romnith/Force-Feedback/README.md

# Force-Feedback
McGill Capstone Design Project - Force Feedback
