romnith/Force-Feedback/Arduino/README.md

## Arduino Code

* **SerialServoNano**: Code flashed to Arduino Nano to control servo motors through serial communication

* **Servo_Test**: Simple code to test servo's angle

Servo motor used: [HS-125MG Slim Metal Gear Wing Servo](https://hitecrcd.com/products/servos/micro-and-mini-servos/analog-micro-and-mini-servos/hs-125mg/product)
