romnith/Force-Feedback/openEMSstim-master/extra/images/android-app/1.a.FindTheNameOfDevice.png

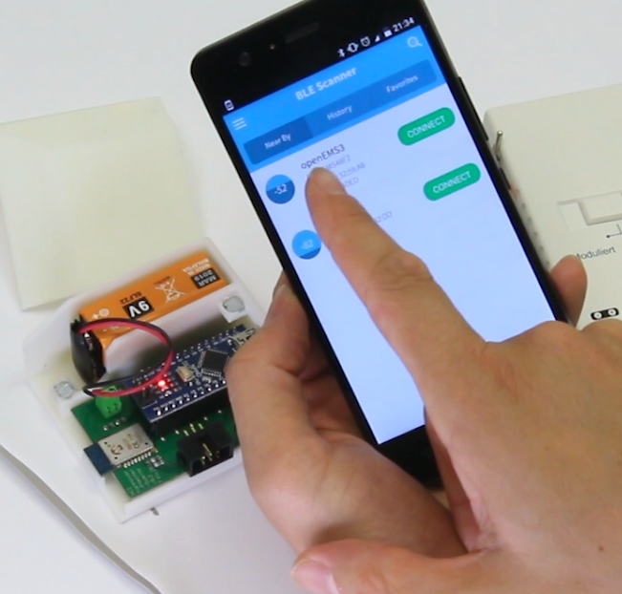
openEMSstim-master/extra/images/android-app/1.a.FindTheNameOfDevice.png
