romnith/Force-Feedback/openEMSstim-master/extra/images/android-app/1.c.BlueLEDisOn.png

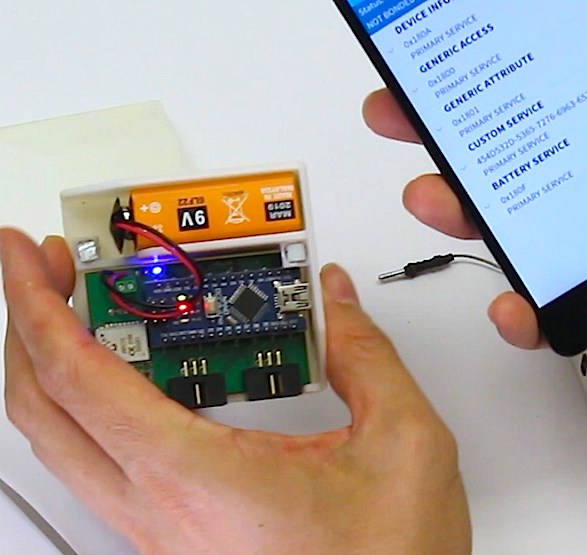
openEMSstim-master/extra/images/android-app/1.c.BlueLEDisOn.png
