romnith/Force-Feedback/openEMSstim-master/extra/images/android-app/2.CheckIfNameIsCorrectOnApp.png

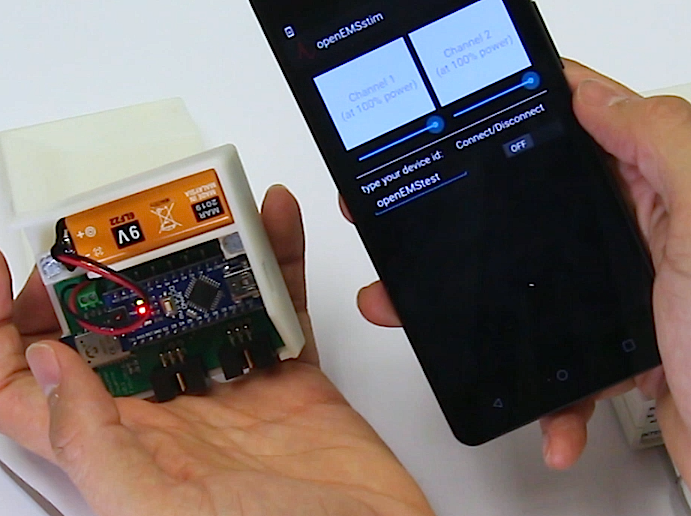
openEMSstim-master/extra/images/android-app/2.CheckIfNameIsCorrectOnApp.png
