romnith/Force-Feedback/openEMSstim-master/extra/images/android-app/2.png

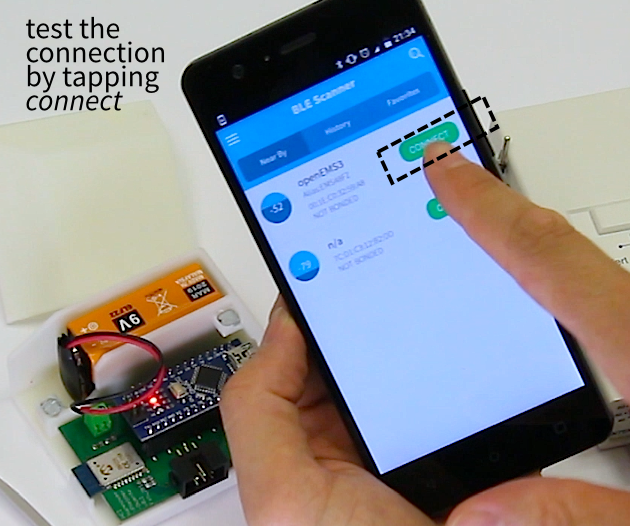
openEMSstim-master/extra/images/android-app/2.png
