romnith/Force-Feedback/openEMSstim-master/extra/images/android-app/3.ChangeTheName.png

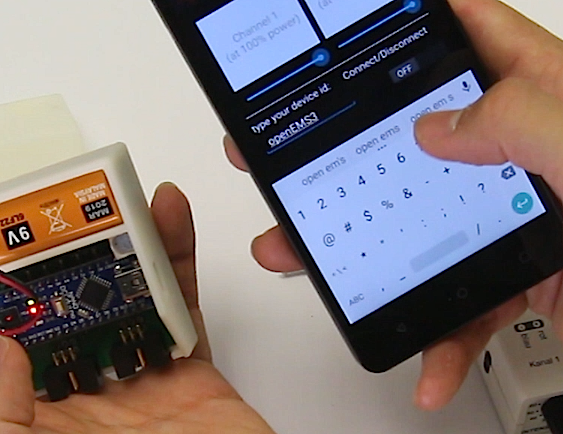
openEMSstim-master/extra/images/android-app/3.ChangeTheName.png
