romnith/Force-Feedback/openEMSstim-master/extra/images/android-app/3.png

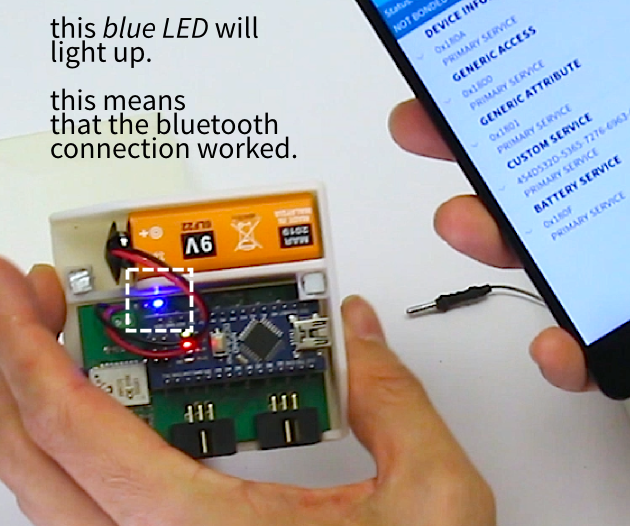
openEMSstim-master/extra/images/android-app/3.png
