romnith/Force-Feedback/openEMSstim-master/extra/images/android-app/4.Connect.png

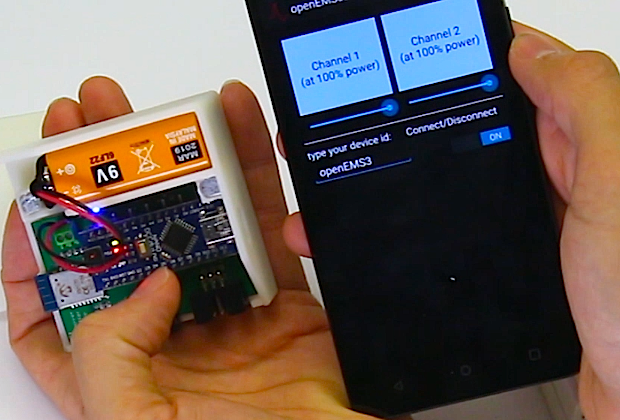
openEMSstim-master/extra/images/android-app/4.Connect.png
