romnith/Force-Feedback/openEMSstim-master/extra/images/android-app/8.SlidersIntenisty.png

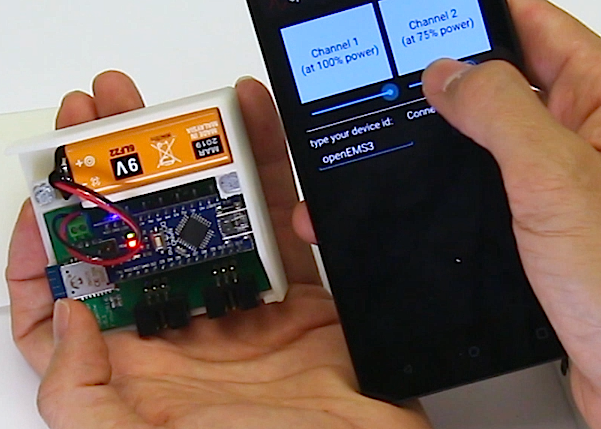
openEMSstim-master/extra/images/android-app/8.SlidersIntenisty.png
