romnith/Force-Feedback/openEMSstim-master/extra/images/cases/lasercut_casing.jpg

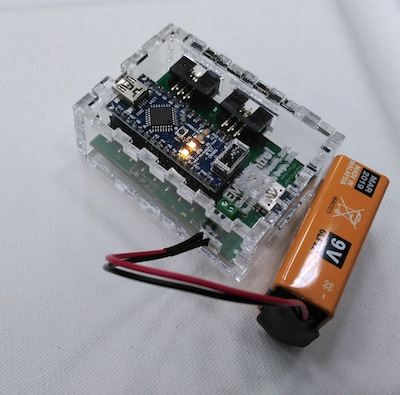
openEMSstim-master/extra/images/cases/lasercut_casing.jpg
