romnith/Force-Feedback/openEMSstim-master/extra/images/connection_diagrams/connecting_to_the_board.png

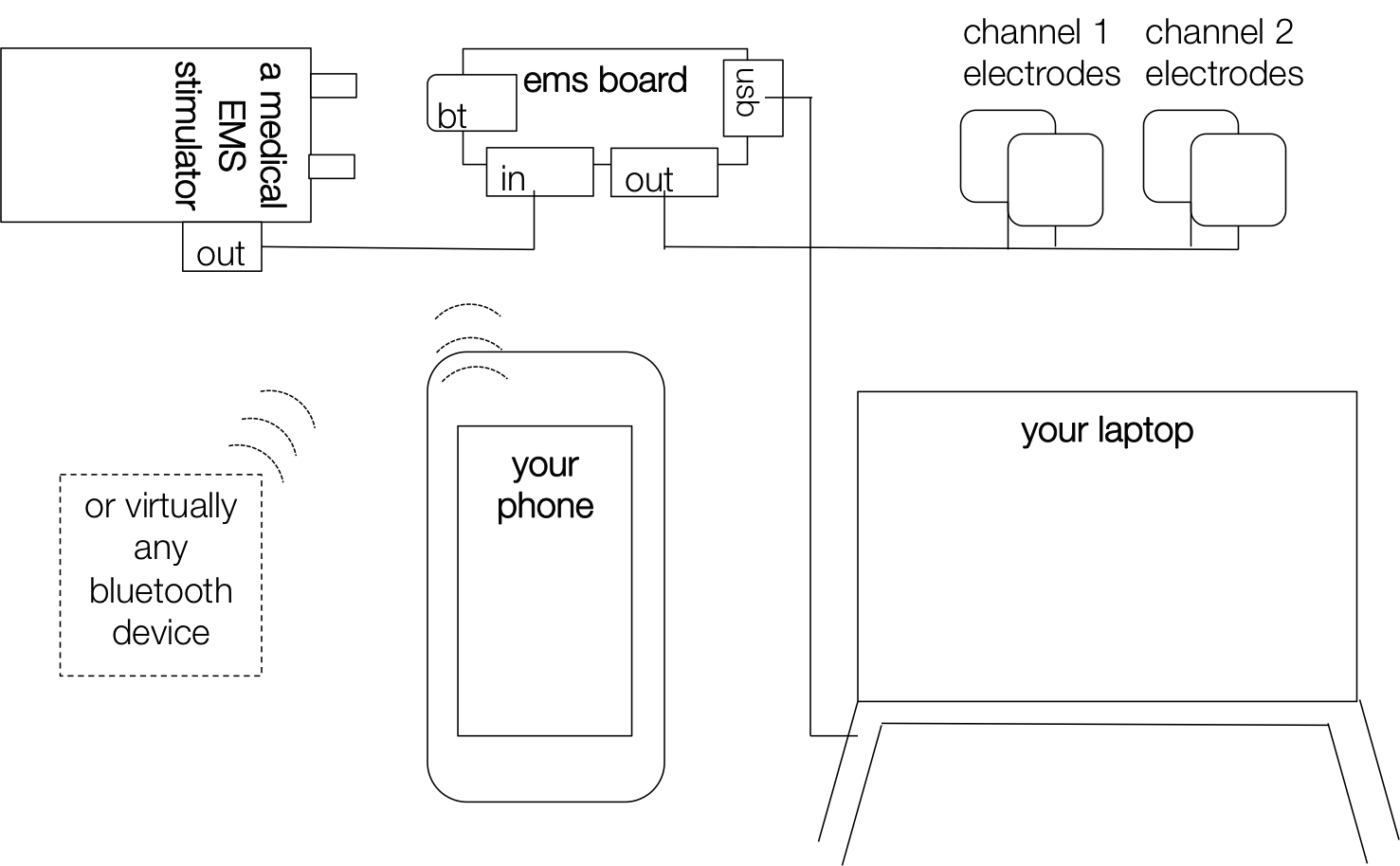
openEMSstim-master/extra/images/connection_diagrams/connecting_to_the_board.png
