romnith/Force-Feedback/openEMSstim-master/extra/images/nodejs/nodejsapp.png

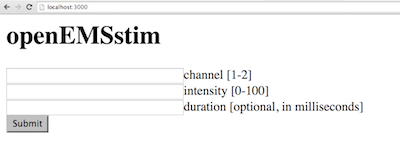
openEMSstim-master/extra/images/nodejs/nodejsapp.png
