romnith/Force-Feedback/openEMSstim-master/extra/images/powering-OFF-openEMSstim/IMG_0092.JPG

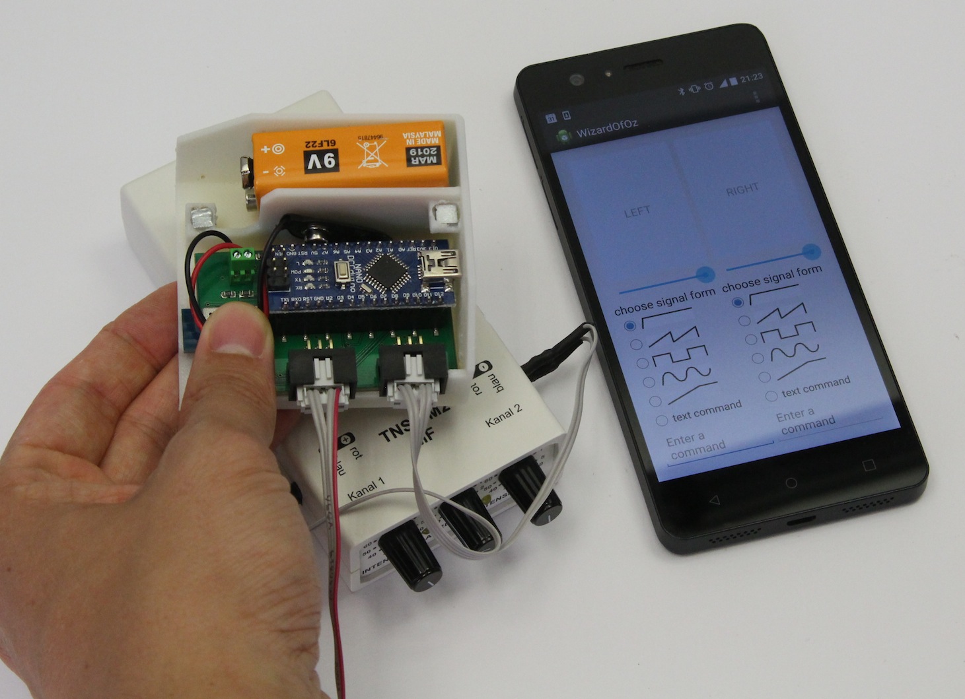
openEMSstim-master/extra/images/powering-OFF-openEMSstim/IMG_0092.JPG
