romnith/Force-Feedback/openEMSstim-master/extra/images/powering-ON-openEMSstim/2.CloseTheLid.jpeg

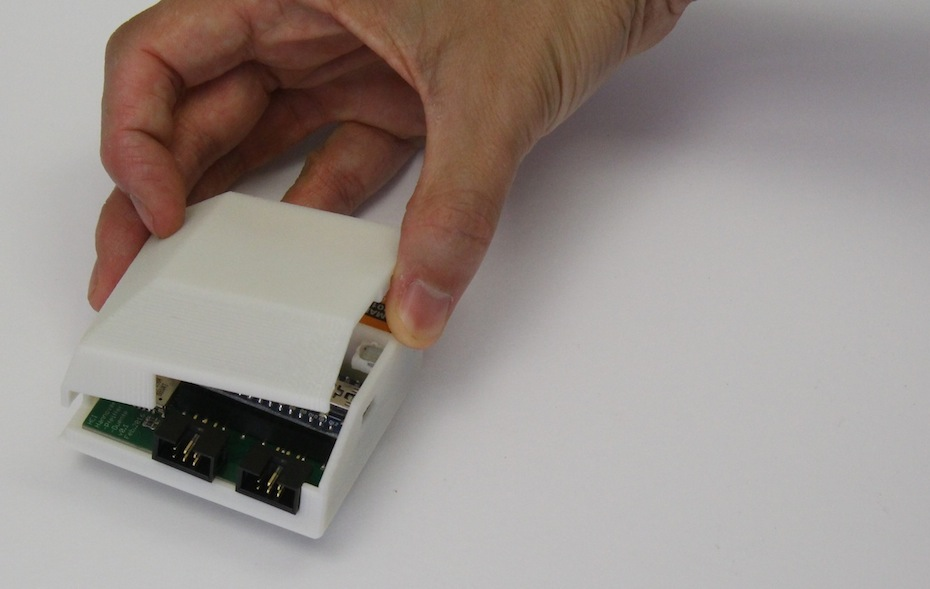
openEMSstim-master/extra/images/powering-ON-openEMSstim/2.CloseTheLid.jpeg
