romnith/Force-Feedback/openEMSstim-master/extra/images/powering-ON-openEMSstim/3.openEMSstim_lidClosed.jpeg

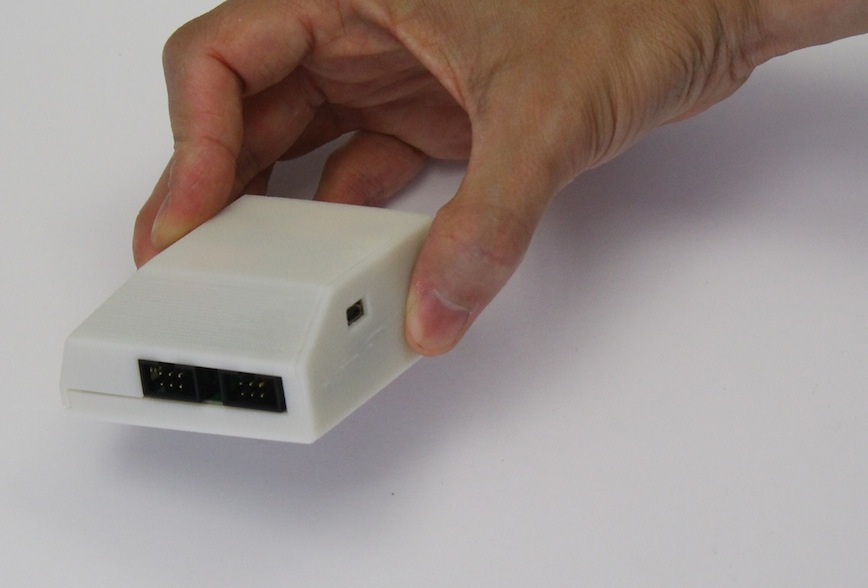
openEMSstim-master/extra/images/powering-ON-openEMSstim/3.openEMSstim_lidClosed.jpeg
