romnith/Force-Feedback/openEMSstim-master/extra/images/python-apps/ems-pong.png

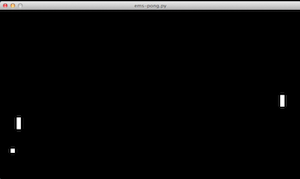
openEMSstim-master/extra/images/python-apps/ems-pong.png
