romnith/Force-Feedback/openEMSstim-master/extra/images/unity3D/1.PlayerSettings.png

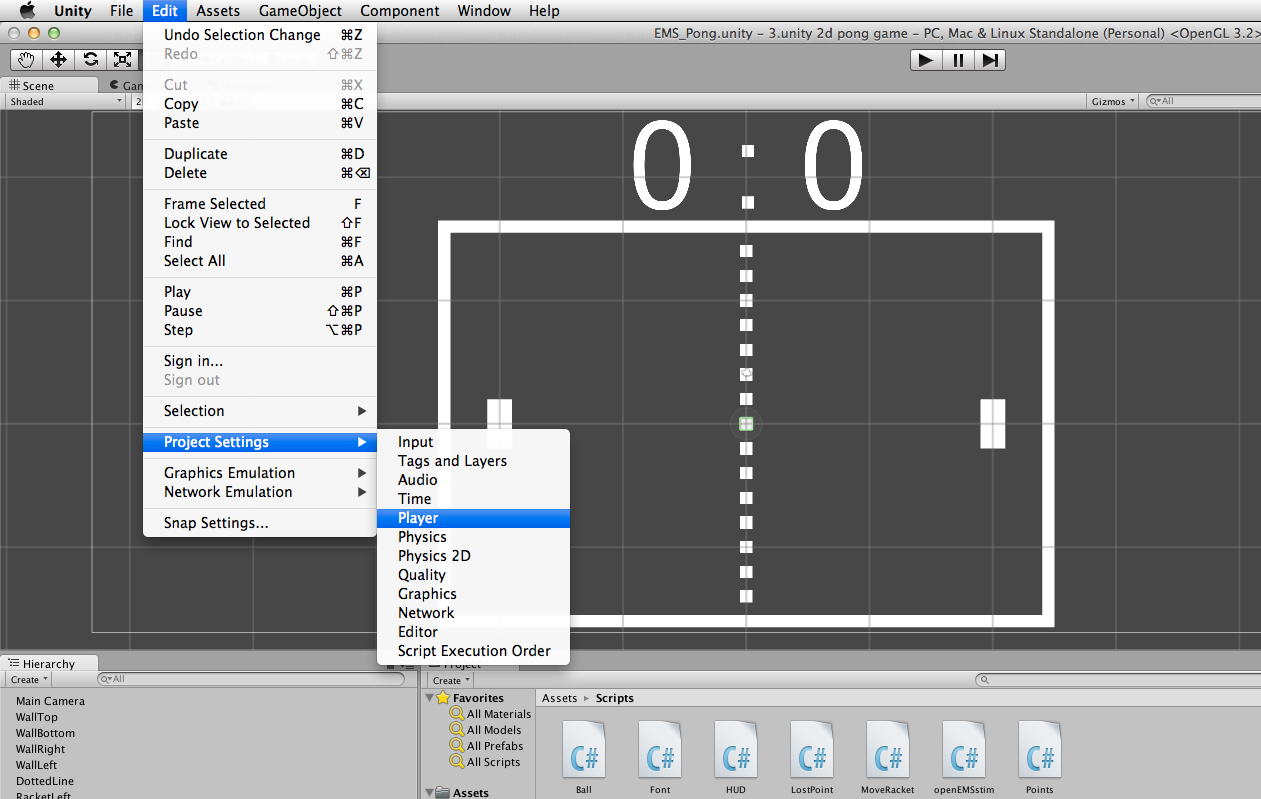
openEMSstim-master/extra/images/unity3D/1.PlayerSettings.png
