romnith/Force-Feedback/openEMSstim-master/extra/images/unity3D/2.ChangeTo.NET2.0.png

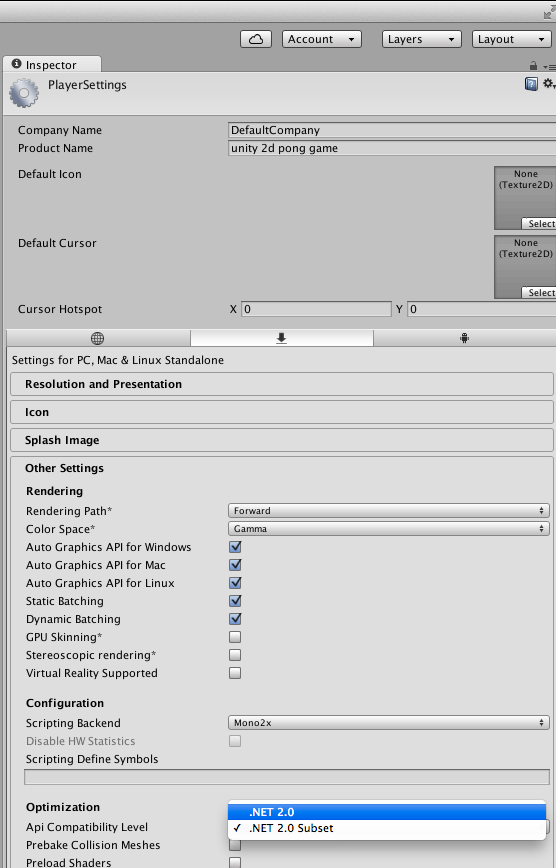
openEMSstim-master/extra/images/unity3D/2.ChangeTo.NET2.0.png
