romnith/Force-Feedback/openEMSstim-master/extra/images/unity3D/3.SelectGameObjectEMScontainer.png

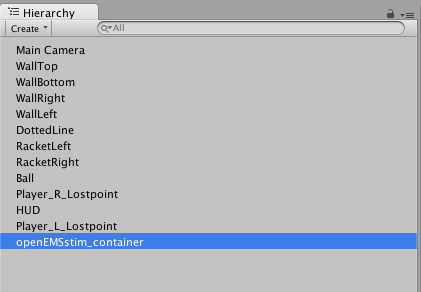
openEMSstim-master/extra/images/unity3D/3.SelectGameObjectEMScontainer.png
