romnith/Force-Feedback/openEMSstim-master/extra/images/unity3D/4.ChangeSerialPort.png

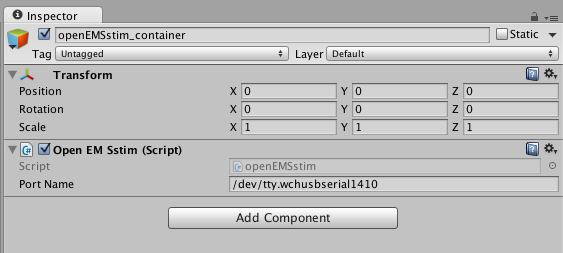
openEMSstim-master/extra/images/unity3D/4.ChangeSerialPort.png
