romnith/Force-Feedback/openEMSstim-master/extra/images/unity3D/5.ChangeCommand.png

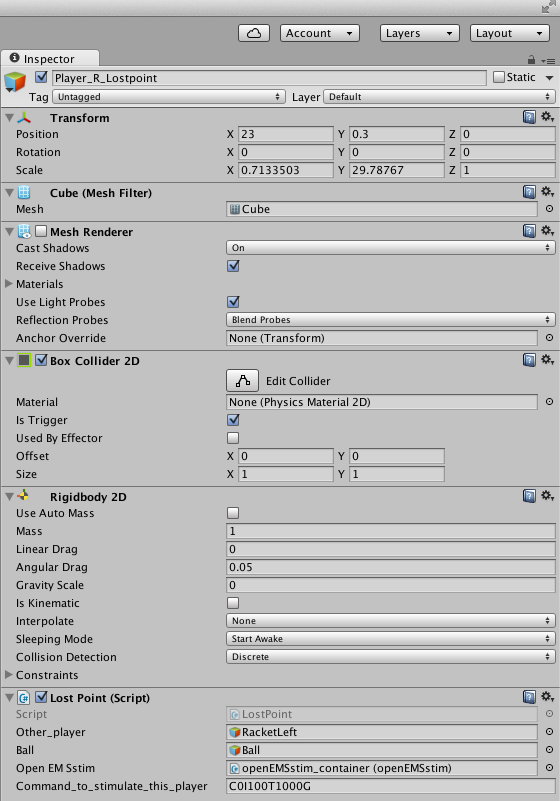
openEMSstim-master/extra/images/unity3D/5.ChangeCommand.png
