romnith/Force-Feedback/openEMSstim-master/extra/images/unity3D/EMS_Pong_Unity.png

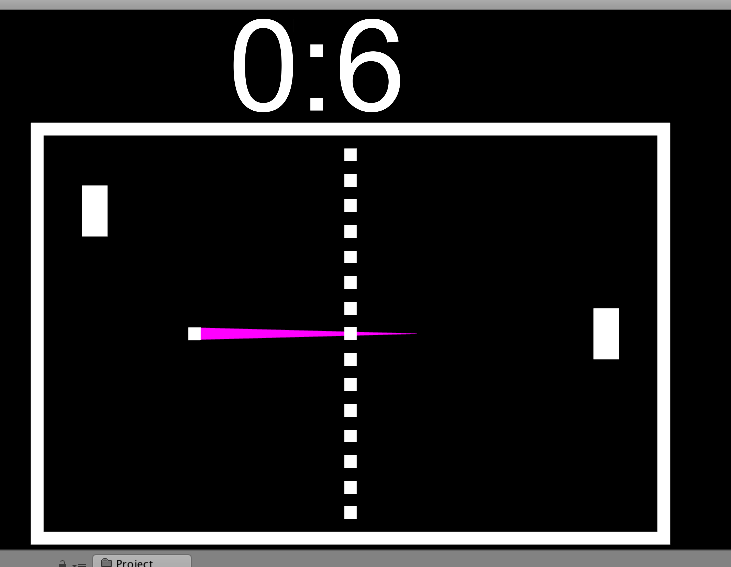
openEMSstim-master/extra/images/unity3D/EMS_Pong_Unity.png
