romnith/Force-Feedback/Unity/MotiveDirect-master/Assets/MixedRealityToolkit-Examples/Demos/StandardShader/Textures/Bricks_normal.png

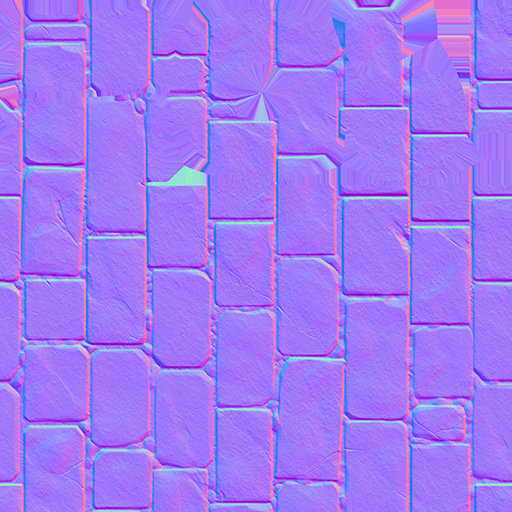
Unity/MotiveDirect-master/Assets/MixedRealityToolkit-Examples/Demos/StandardShader/Textures/Bricks_normal.png
