romnith/Force-Feedback/Unity/MotiveDirect-master/Assets/MixedRealityToolkit-Examples/Demos/StandardShader/Textures/Fabric_normal.png

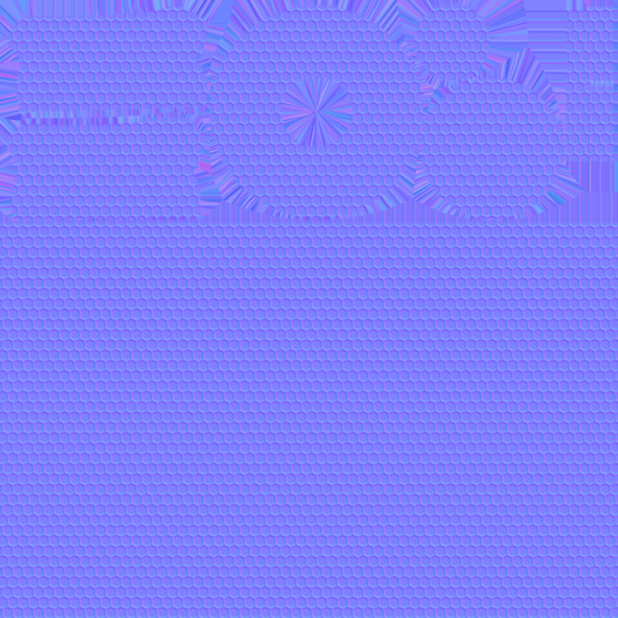
Unity/MotiveDirect-master/Assets/MixedRealityToolkit-Examples/Demos/StandardShader/Textures/Fabric_normal.png
