romnith/Force-Feedback/Unity/MotiveDirect-master/Assets/MixedRealityToolkit-Examples/Demos/StandardShader/Textures/OpaqueHoverLight_albedo.png

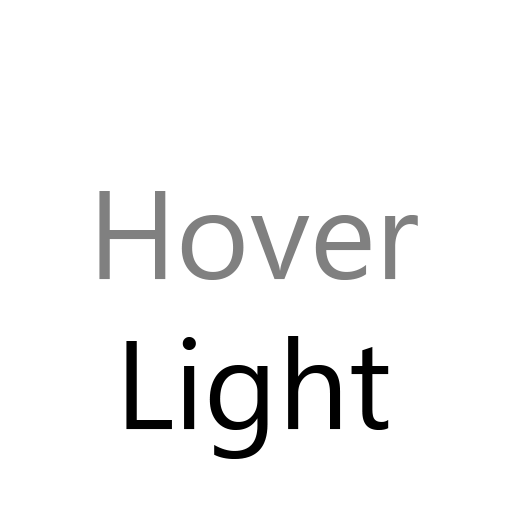
Unity/MotiveDirect-master/Assets/MixedRealityToolkit-Examples/Demos/StandardShader/Textures/OpaqueHoverLight_albedo.png
