romnith/Force-Feedback/Unity/MotiveDirect-master/Assets/MixedRealityToolkit/_Core/Resources/Textures/Generic_controller_black_scaled.png

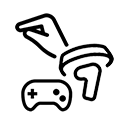
Unity/MotiveDirect-master/Assets/MixedRealityToolkit/_Core/Resources/Textures/Generic_controller_black_scaled.png
