romnith/Force-Feedback/Unity/MotiveDirect-master/Assets/MixedRealityToolkit/_Core/Resources/Textures/MotionController_left_white.png

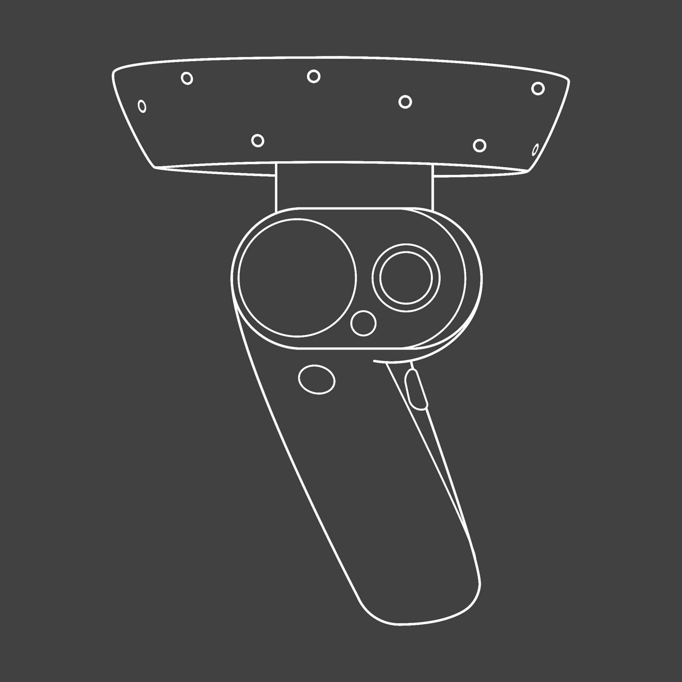
Unity/MotiveDirect-master/Assets/MixedRealityToolkit/_Core/Resources/Textures/MotionController_left_white.png
