romnith/Force-Feedback/Unity/MotiveDirect-master/Assets/Models/TableModel/_Models/Table_Textures/Table_New_Connected_Low_Metal_Normal.png

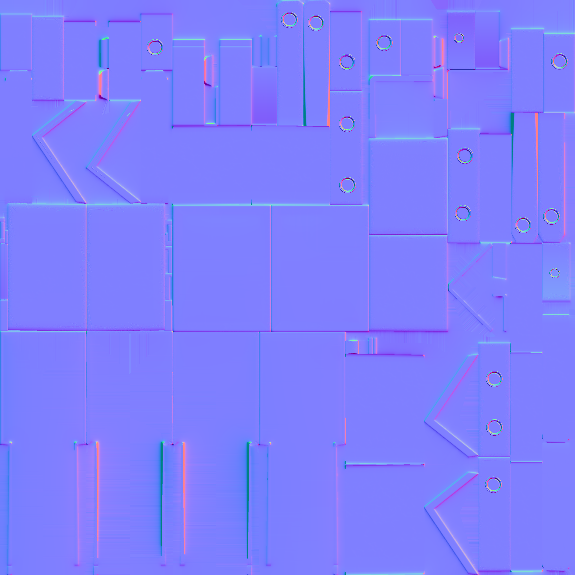
Unity/MotiveDirect-master/Assets/Models/TableModel/_Models/Table_Textures/Table_New_Connected_Low_Metal_Normal.png
