romnith/Force-Feedback/openEMSstim-master/hardware/Casings/3dPrintedCasing/bottom-part.stl

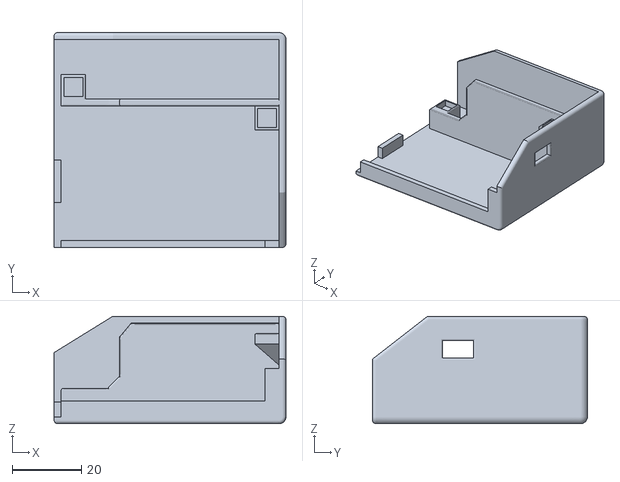
[picture p79: CAD file, 2018-11-25]
openEMSstim-master/hardware/Casings/3dPrintedCasing/bottom-part.stl
67.0 x 62.0 x 31.0
