romnith/Force-Feedback/Unity/MotiveDirect-master/Assets/Models/Bottle.obj

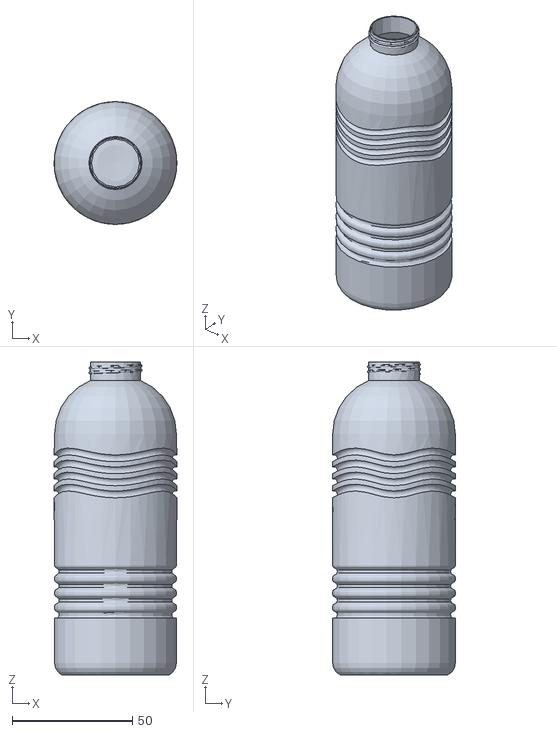
[picture p80: CAD file, 2018-10-29]
Unity/MotiveDirect-master/Assets/Models/Bottle.obj
51.0 x 51.0 x 130.0
