romnith/Force-Feedback/openEMSstim-master/hardware/Casings/3dPrintedCasing/top-part.stl

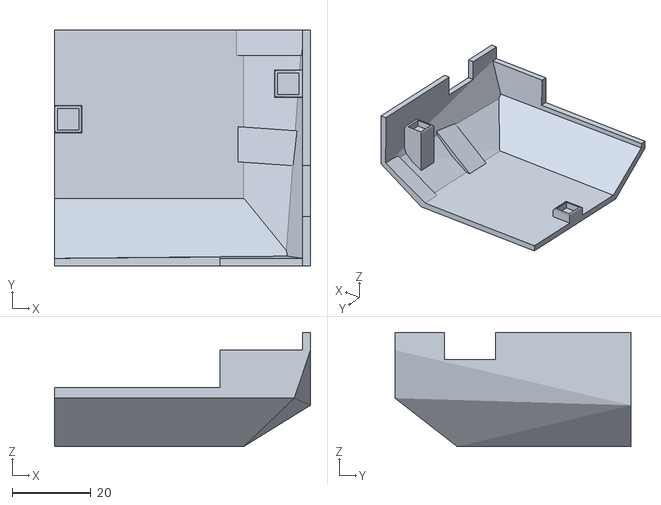
[picture p81: CAD file, 2018-11-25]
openEMSstim-master/hardware/Casings/3dPrintedCasing/top-part.stl
65.0 x 60.0 x 29.0
