romnith/Force-Feedback/openEMSstim-master/extra/images/building/Connectors.jpg

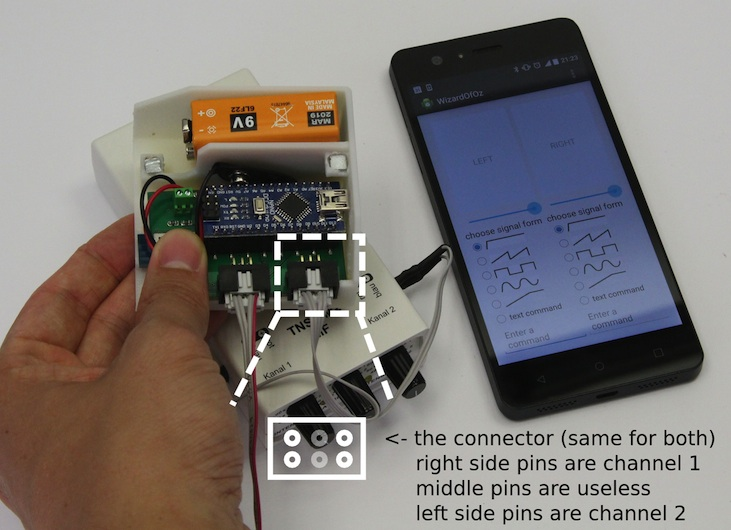
openEMSstim-master/extra/images/building/Connectors.jpg
