romnith/Force-Feedback/openEMSstim-master/extra/images/cases/3dPrintedCasing.jpg

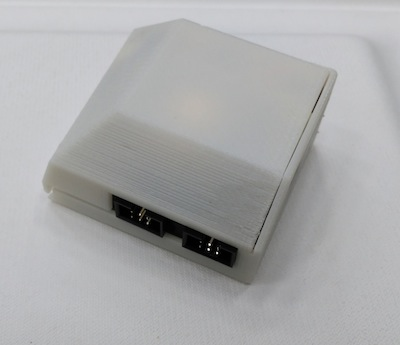
openEMSstim-master/extra/images/cases/3dPrintedCasing.jpg
