romnith/Force-Feedback/openEMSstim-master/extra/images/getting-started/2-checking-ID.jpeg

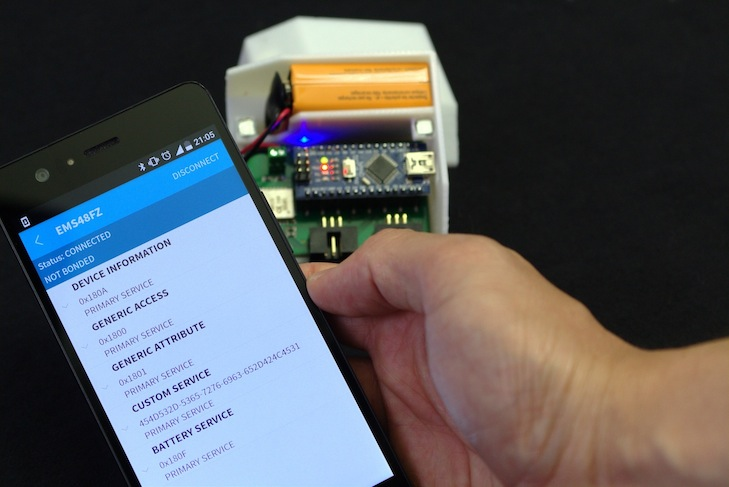
openEMSstim-master/extra/images/getting-started/2-checking-ID.jpeg
