romnith/Force-Feedback/openEMSstim-master/extra/images/getting-started/3-conecting-via-Android.jpeg

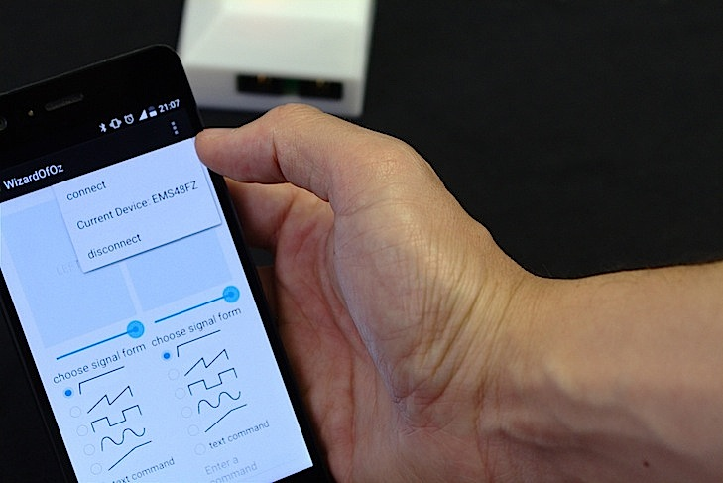
openEMSstim-master/extra/images/getting-started/3-conecting-via-Android.jpeg
