romnith/Force-Feedback/openEMSstim-master/extra/images/youtube/tutorial-EMSbasics.png

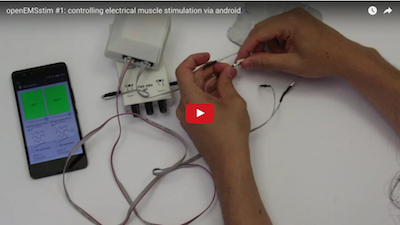
openEMSstim-master/extra/images/youtube/tutorial-EMSbasics.png
