romnith/Force-Feedback/openEMSstim-master/extra/images/android-app/1.b.TapConnectToTest.png

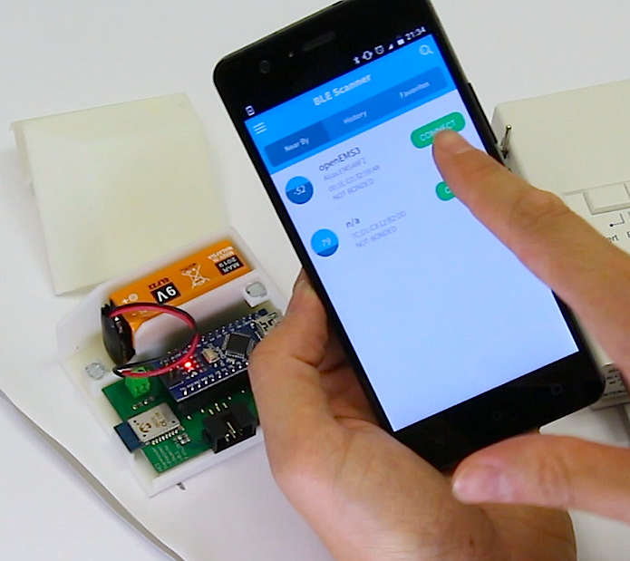
openEMSstim-master/extra/images/android-app/1.b.TapConnectToTest.png
