romnith/Force-Feedback/openEMSstim-master/extra/images/android-app/6.TestLEDsForRight.png

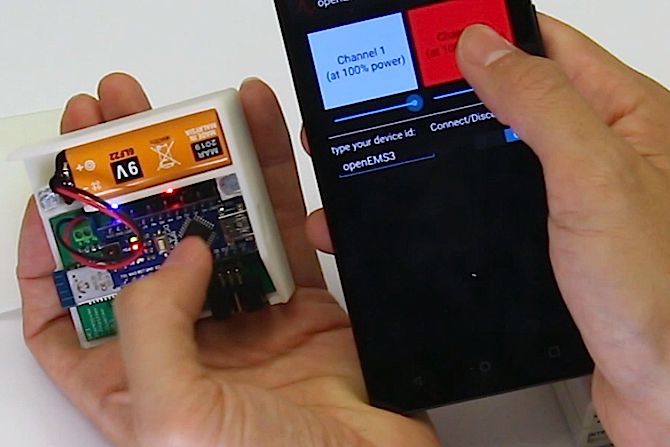
openEMSstim-master/extra/images/android-app/6.TestLEDsForRight.png
