romnith/Force-Feedback/openEMSstim-master/extra/images/android-app/7.TestLEDsForLeft.png

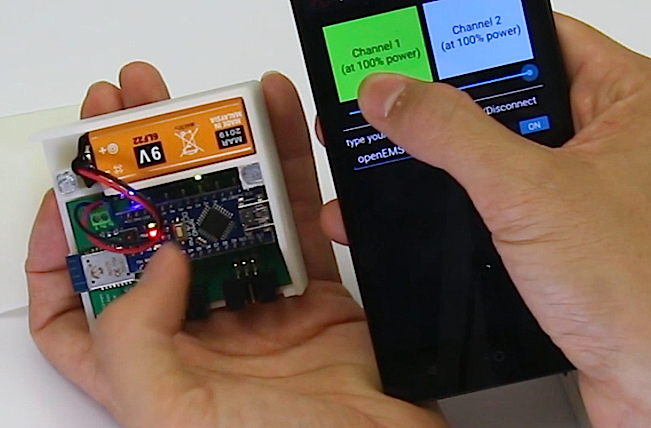
openEMSstim-master/extra/images/android-app/7.TestLEDsForLeft.png
