romnith/Force-Feedback/Unity/Force Feedback Leap Test/Assets/LeapMotion/Core/EditorResources/HandTex.png

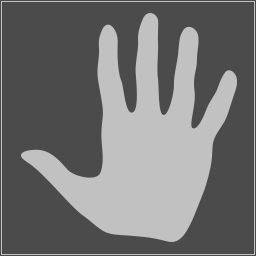
Unity/Force Feedback Leap Test/Assets/LeapMotion/Core/EditorResources/HandTex.png
