romnith/Force-Feedback/Unity/Force Feedback Leap Test/Assets/LeapMotion/Core/Gizmos/leap_motion.png

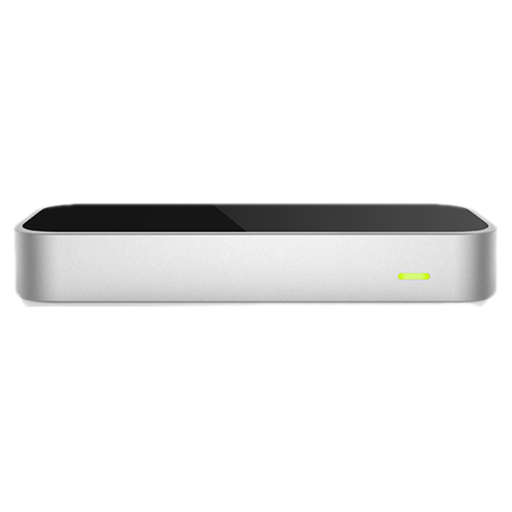
Unity/Force Feedback Leap Test/Assets/LeapMotion/Core/Gizmos/leap_motion.png
