romnith/Force-Feedback/Unity/Force Feedback Leap Test/Assets/LeapMotion/Core/Textures/LoPolyHand_Color.png

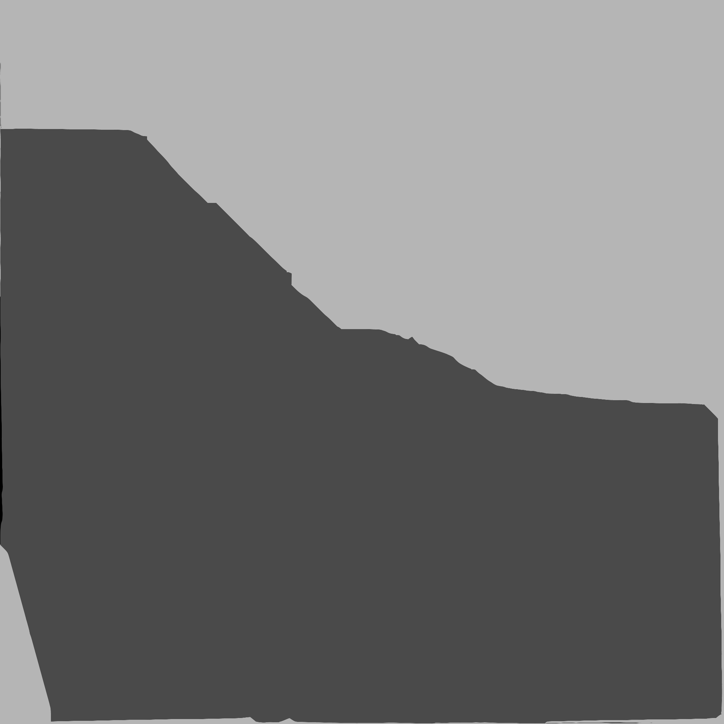
Unity/Force Feedback Leap Test/Assets/LeapMotion/Core/Textures/LoPolyHand_Color.png
