romnith/Force-Feedback/Unity/Force Feedback Leap Test/Assets/LeapMotion/Core/Textures/PluginLeapNotice.png

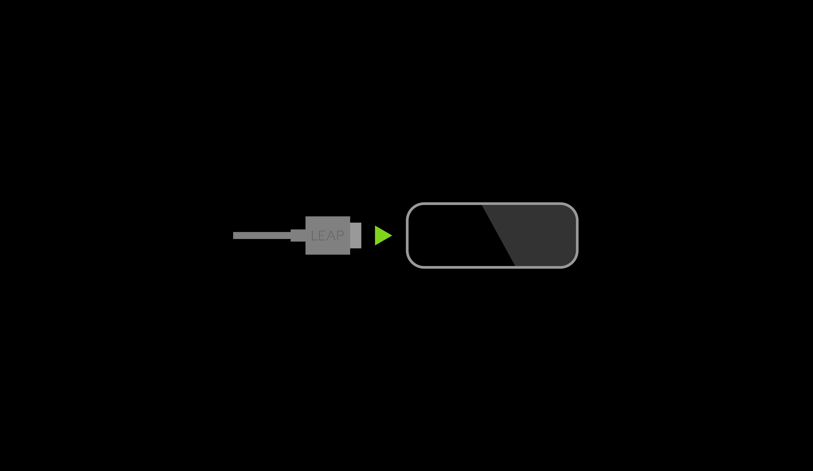
Unity/Force Feedback Leap Test/Assets/LeapMotion/Core/Textures/PluginLeapNotice.png
