romnith/Force-Feedback/Unity/Force Feedback Leap Test/Assets/LeapMotion/Core/Textures/PluginLeapNoticeLarge.png

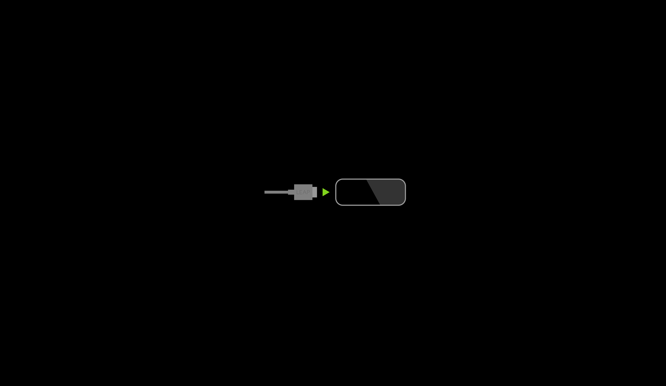
Unity/Force Feedback Leap Test/Assets/LeapMotion/Core/Textures/PluginLeapNoticeLarge.png
