romnith/Force-Feedback/openEMSstim-master/hardware/schematics/openEMSstim_03.brd

## EAGLE design openEMSstim-master/hardware/schematics/openEMSstim_03.brd (2018-11-25)

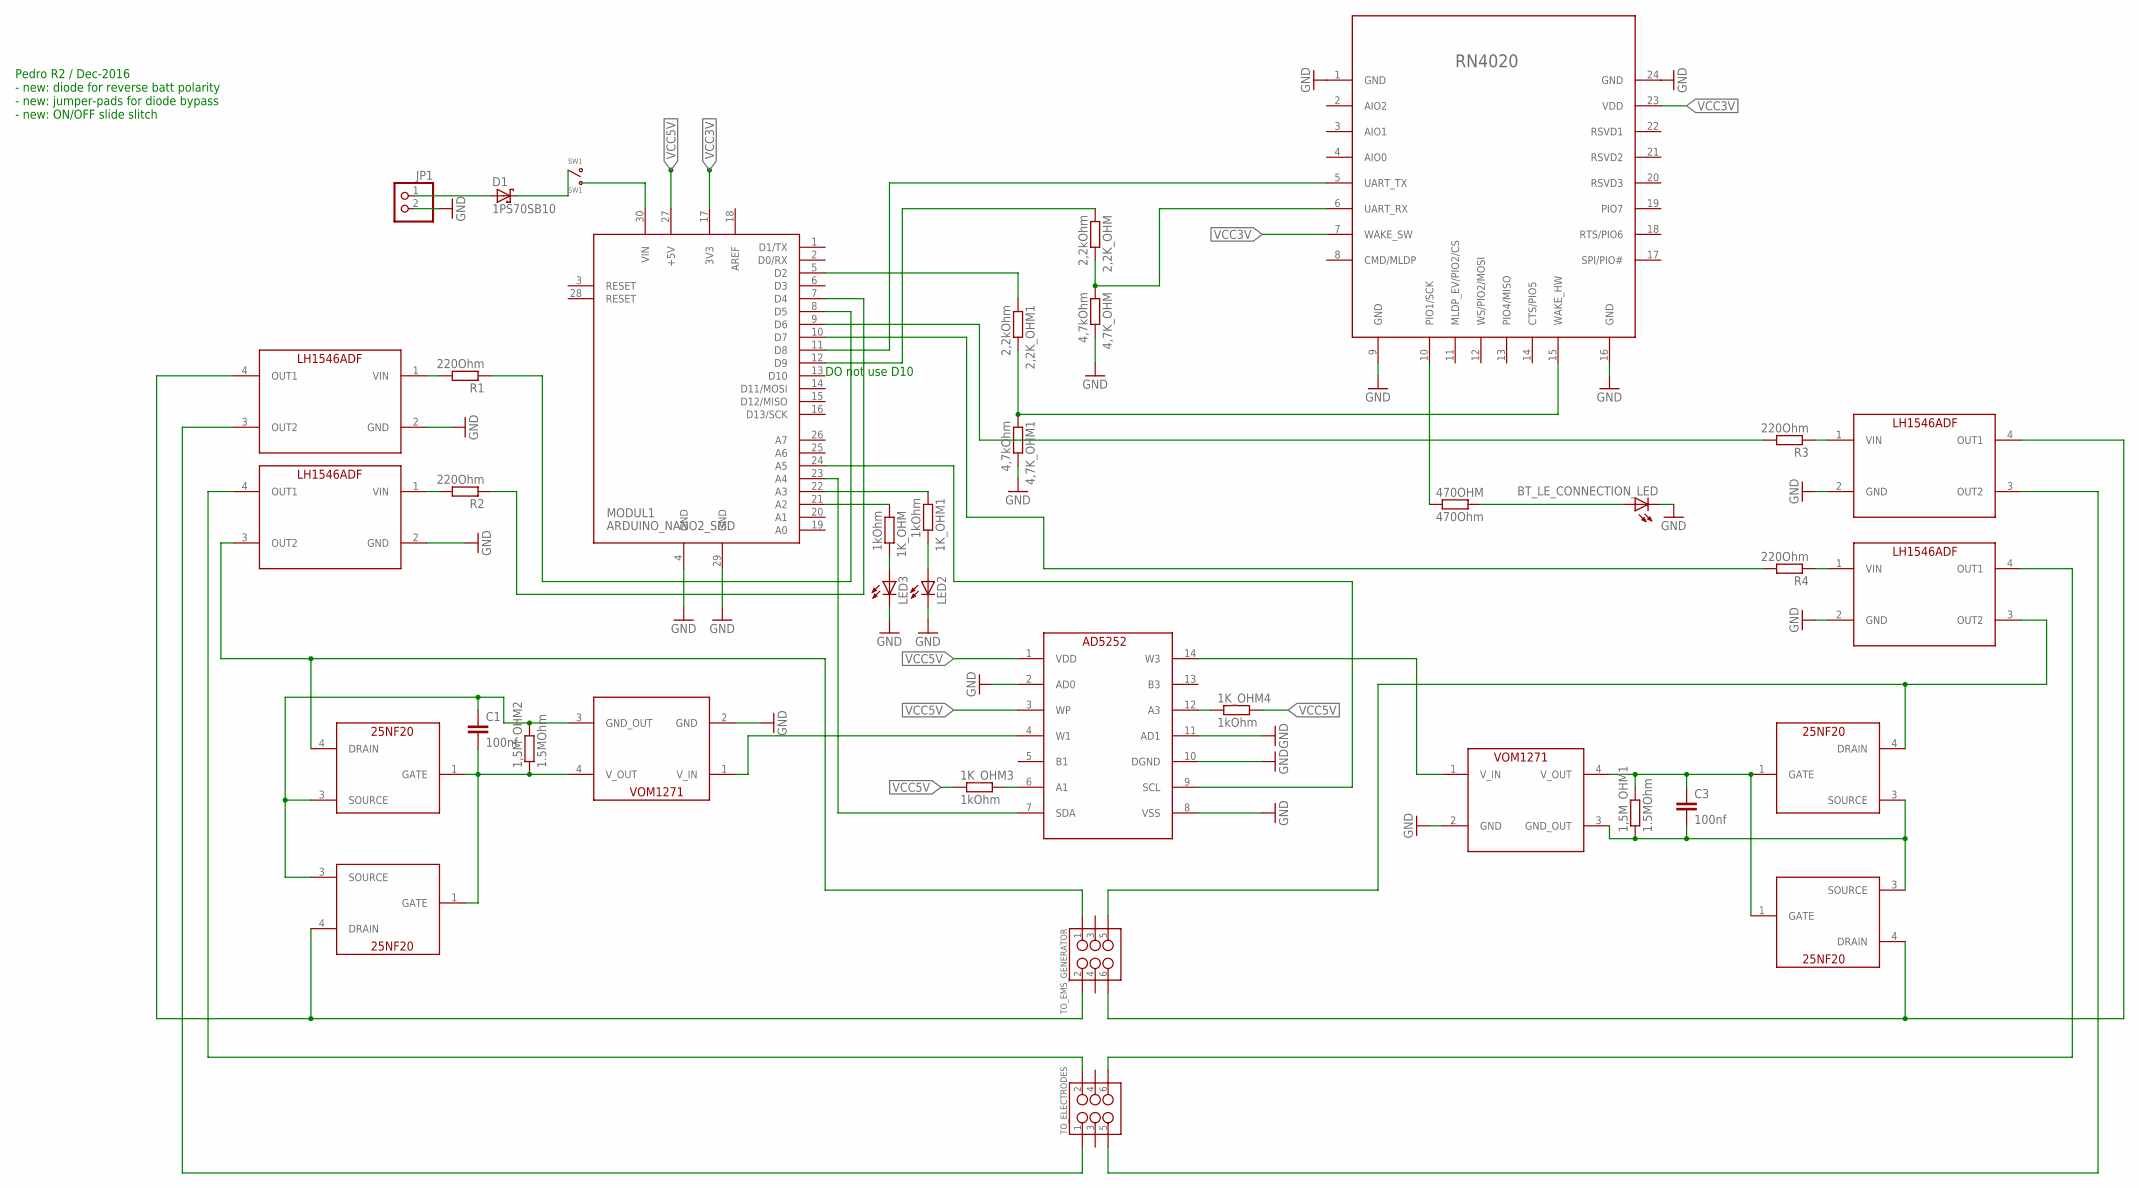
[picture p113: schematic openEMSstim_03.sch]

Parts:
1,5M_OHM1, 1,5M_OHM2: 1.5MOhm; R0805
1K_OHM, 1K_OHM1, 1K_OHM3, 1K_OHM4: 1kOhm; R0805
2,2K_OHM, 2,2K_OHM1: 2,2kOhm; R0805
4,7K_OHM, 4,7K_OHM1: 4,7kOhm; R0805
470OHM: 470Ohm; R0805
BT_LE_CONNECTION_LED: LEDCHIPLED_0603; CHIPLED_0603
C1, C3: 100nf; 0805
D1: 1PS70SB10; SOT323
JP1: PINHD-1X2; 1X02
LED2, LED3: LEDCHIPLED_0603; CHIPLED_0603
MODUL1: ARDUINO_NANO2_SMD
MOS01, MOS02, MOS03, MOS04: DEV; PACK
R1, R2, R3, R4: 220Ohm; R0805
SW1: SW1; SSSS810701
TO_ELECTRODES: M03X2; RIGHT_ANGLED_SHROUED_2X06_6PIN
TO_EMS_GENERATOR: M03X2; RIGHT_ANGLED_SHROUED_2X06_6PIN
U$5: RN4020
U$6: AD5252; TSSOP
U$9, U$10: VOM1271; SOP04
U$11, U$12, U$13, U$14: LH1546ADF; DIP04-SMD

Connections:
AREF: MODUL1.18 (AREF)
GND: 4,7K_OHM.2, 4,7K_OHM1.2, BT_LE_CONNECTION_LED.C, JP1.2, LED2.C, LED3.C, MODUL1.4 (GND), MODUL1.29 (GND), U$5.1 (GND), U$5.9 (GND), U$5.16 (GND), U$5.24 (GND), U$6.2 (AD0), U$6.8 (VSS), U$6.10 (DGND), U$6.11 (AD1), U$9.2 (GND), U$10.2 (GND), U$11.2 (GND), U$12.2 (GND), U$13.2 (GND), U$14.2 (GND)
unnamed: U$6.4 (W1), U$9.1 (V_IN)
unnamed: 1K_OHM.1, MODUL1.21 (A2)
unnamed: MODUL1.23 (A4), U$6.7 (SDA)
unnamed: TO_ELECTRODES.6, U$14.4 (OUT1)
unnamed: 2,2K_OHM.2, 4,7K_OHM.1, U$5.6 (UART_RX)
unnamed: 2,2K_OHM.1, MODUL1.12 (D9)
unnamed: TO_ELECTRODES.1, U$11.3 (OUT2)
unnamed: 1,5M_OHM2.1, C1.2, MOS01.1 (GATE), MOS02.1 (GATE), U$9.4 (V_OUT)
unnamed: MODUL1.11 (D8), U$5.5 (UART_TX)
unnamed: MODUL1.24 (A5), U$6.9 (SCL)
unnamed: MODUL1.30 (VIN), SW1.1 (B)
unnamed: R2.2, U$12.1 (VIN)
unnamed: TO_ELECTRODES.2, U$12.4 (OUT1)
unnamed: R1.2, U$11.1 (VIN)
unnamed: R3.1, U$13.1 (VIN)
unnamed: R4.1, U$14.1 (VIN)
unnamed: MODUL1.8 (D5), R1.1
unnamed: MODUL1.7 (D4), R2.1
unnamed: MODUL1.9 (D6), R3.2
unnamed: MODUL1.10 (D7), R4.2
unnamed: MOS01.4 (DRAIN), TO_EMS_GENERATOR.1, U$12.3 (OUT2)
unnamed: U$6.14 (W3), U$10.1 (V_IN)
unnamed: 1,5M_OHM1.2, C3.1, MOS03.1 (GATE), MOS04.1 (GATE), U$10.4 (V_OUT)
unnamed: 1,5M_OHM1.1, C3.2, MOS03.3 (SOURCE), MOS04.3 (SOURCE), U$10.3 (GND_OUT)
unnamed: 1K_OHM4.1, U$6.12 (A3)
unnamed: 1,5M_OHM2.2, C1.1, MOS01.3 (SOURCE), MOS02.3 (SOURCE), U$9.3 (GND_OUT)
unnamed: MOS03.4 (DRAIN), TO_EMS_GENERATOR.5, U$14.3 (OUT2)
unnamed: MOS02.4 (DRAIN), TO_EMS_GENERATOR.2, U$11.4 (OUT1)
unnamed: TO_ELECTRODES.5, U$13.3 (OUT2)
unnamed: MOS04.4 (DRAIN), TO_EMS_GENERATOR.6, U$13.4 (OUT1)
unnamed: 2,2K_OHM1.2, 4,7K_OHM1.1, U$5.15 (WAKE_HW)
unnamed: 1K_OHM3.2, U$6.6 (A1)
unnamed: 2,2K_OHM1.1, MODUL1.5 (D2)
unnamed: 470OHM.1, U$5.10 (PIO1/SCK)
unnamed: 470OHM.2, BT_LE_CONNECTION_LED.A
unnamed: 1K_OHM1.2, LED2.A
unnamed: 1K_OHM1.1, MODUL1.22 (A3)
unnamed: 1K_OHM.2, LED3.A
unnamed: D1.1 (A), JP1.1
unnamed: D1.3 (K), SW1.2 (COM)
VCC3V: MODUL1.17 (3V3), U$5.7 (WAKE_SW), U$5.23 (VDD)
VCC5V: 1K_OHM3.1, 1K_OHM4.2, MODUL1.27 (+5V), U$6.1 (VDD), U$6.3 (WP)

Notes on the sheet:
DO not use D10
Pedro R2 / Dec-2016 - new: diode for reverse batt polarity - new: jumper-pads for diode bypass - new: ON/OFF slide slitch

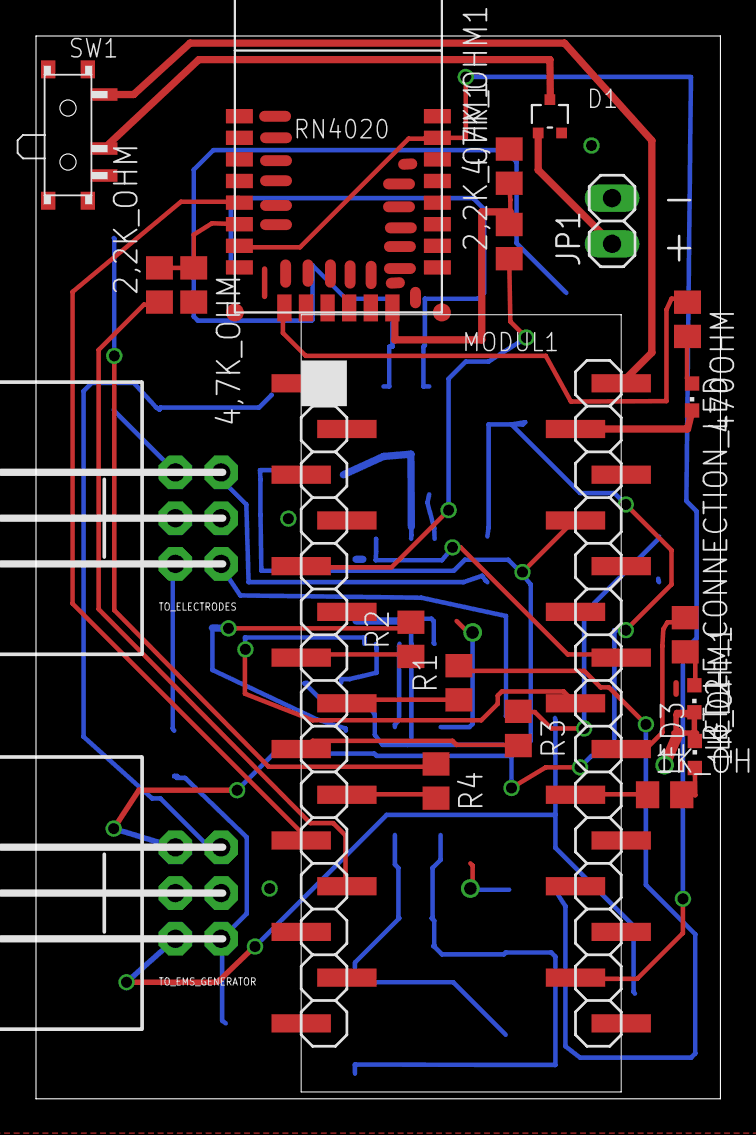
[picture p114: board openEMSstim_03.brd from above]

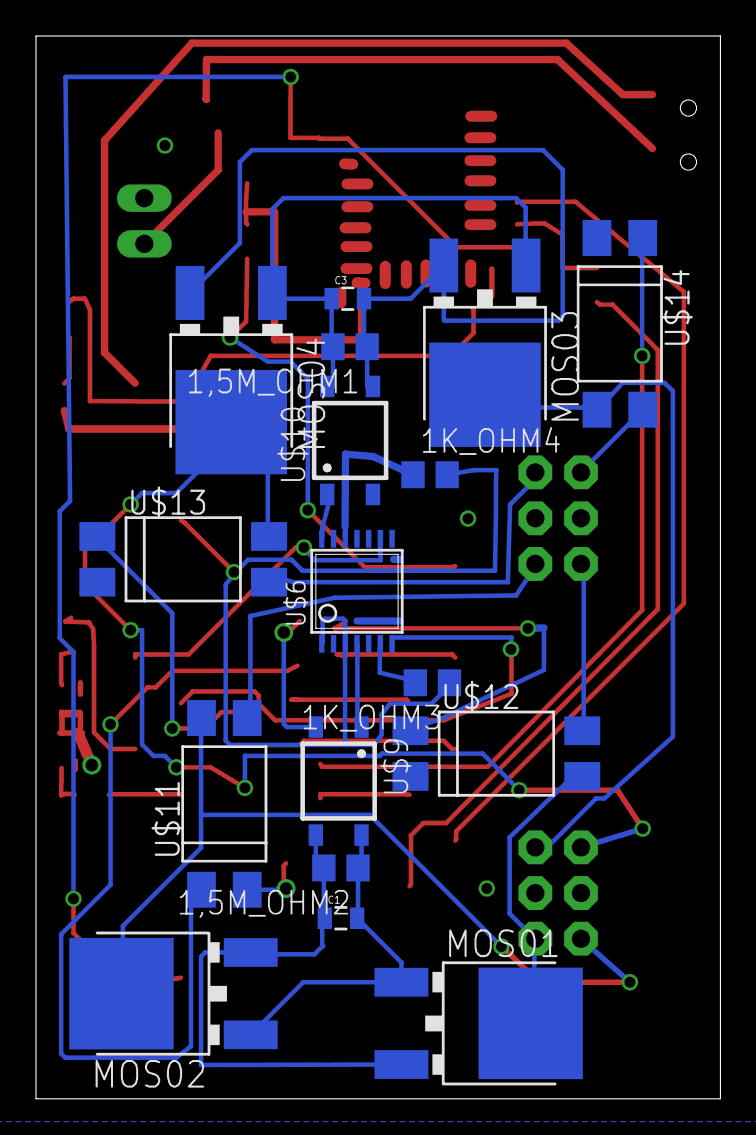
[picture p115: board openEMSstim_03.brd from below]

Board: 2 copper layers, 38.0 x 59.0 mm, 38 parts (17 on the bottom side), 43 nets.
