romnith/Force-Feedback/(commit log)

2018-03-01 arduino folder init
2018-03-01 servo testing arduino code
2018-03-24 Unity Arduino integration start
2018-03-27 working serial unity-arduino but not correct values for no collision
    [Servo_Test.ino]
2018-10-29 New scene with bottle
    [Bottle.obj]
2018-11-16 serial implementation
    [Bottle.obj]
2018-11-25 EMS implementation + imported VR packages
    [bottom-part.stl, openEMSstim_03.brd, openEMSstim_03.sch, top-part.stl]
2018-12-04 Update and rename README.md to ArduinoREADME.md
